faaiqm7/c5-elec391/SCRUM/SCRUM MAR-04-2025.pdf

### Scrum Results Sheet:

Team Number: L2C-C5 | Date: March-4-2025

### Scrum Master Initials: F.M

Name #1 | Adarsh Sood
| Since last scrum: - Designed new wheels

Working on today:
- Printing new wheels and designing holder for magnetic encoder Roadblocks:
- None
Name #2 | Samarr Parmaar
| Since last scrum: - Modeling of Robot

Working on today:
- Modeling of Robot and finding certain parameters
- Tuning PID coefficients
Roadblocks:
- Different methods of modeling the robot
Name #3 | Faaiq Majeed
| Since last scrum: - Worked on balancing the robot code

Working on today:
- Tuning the robot code to make it more efficient as well as creating a GUI to tune it more easily
Roadblocks:
- Robot was too jerky
