faaiqm7/c5-elec391/SCRUM/SCRUM MAR-06-2025.pdf

### Scrum Results Sheet:

Team Number: L2C-C5 | Date: March-6-2025

### Scrum Master Initials: S.P

Name #1 | Adarsh Sood
| Since last scrum: - Designed the magnetic encoder

Working on today:
- Print the magnetic encoder for the wheels
- Work on testing the magnetic encoder Roadblocks:
- None
Name #2 | Samarr Parmaar
| Since last scrum: - Modeling of Robot and helping to tune PID coefficients

Working on today:
- Modeling of Robot and finding certain parameters
- Tuning PID system
Roadblocks:
- None
Name #3 | Faaiq Majeed
| Since last scrum: - Improved the code for the self balancing robot

Working on today:
- Continue to fix inefficiencies in the self balancing robot code
- Test magnetic encoder
Roadblocks:
- Motor makes a loud sound due to the low frequency switching (turning it to 20Khz)
