faaiqm7/c5-elec391/SCRUM/SCRUM FEB-25-2025.pdf

### Scrum Results Sheet:

Team Number: L2C-C5 | Date: Feb-25-2025

### Scrum Master Initials: AS

Name #1 | Adarsh Sood
| Since last scrum: - Designed New wheels for distance tracking, ordered components like IR

Working on today:
- Rewiring to help prevent issues while testing PID due to jidders

Roadblocks:
- None
Name #2 | Samarr Parmaar
| Since last scrum: - Started looking into more research papers and 341 notes

Working on today:
- Starting to find out Gp and different parameters for making control model

Roadblocks:
- Two midterms
Name #3 | Faaiq Majeed
| Since last scrum: - Wrote a script to test PID coefficients

Working on today:
- Heuristic tunning of random PID coefficients to test code

Roadblocks:
- None
