faaiqm7/c5-elec391/SCRUM/SCRUM FEB-27-2025.pdf

### Scrum Results Sheet:

Team Number: L2C-C5 | Date: Feb-27-2025

### Scrum Master Initials: SP

Name #1 | Adarsh Sood
| Since last scrum: - Designed new IR mounts for the wheels

Working on today:
- Testing the effect of center of mass with current PID code Roadblocks:
- None
Name #2 | Samarr Parmaar
| Since last scrum: - Found Ga, starting to write matlab code

Working on today:
- Finding parameters like Gp, Ga, Hp, Hs

Roadblocks:
- Two midterms
Name #3 | Faaiq Majeed
| Since last scrum: - Adding more parameters aiding testing for PID code

Working on today:
- Helping Samarr in making basic control model

Roadblocks:
- None
