faaiqm7/c5-elec391/SCRUM/SCRUM FEB-13-2025.pdf

### Scrum Results Sheet:

Team Number: L2C-C5 | Date: Feb-13-2025

### Scrum Master Initials: FM

Name #1 | Adarsh Sood
| Since last scrum: - Re-printed a few items

Working on today:
- Work on Extra Features Proposal

Roadblocks:
- None
Name #2 | Samarr Parmaar
| Since last scrum: - Assembled the new 3D printed parts onto the robot.

Working on today:
- Work on Extra Features Proposal
- Discuss the approach we will take to implement the control system for the robot.

Roadblocks:
- None
Name #3 | Faaiq Majeed
| Since last scrum: - Worked on the GUI and testing of the robot circuitry.

Working on today:
- Work on Extra Features Proposal

Roadblocks:
- None
