faaiqm7/c5-elec391/SCRUM/SCRUM FEB-11-2025.pdf

### Scrum Results Sheet:

Team Number: L2C-C5 | Date: Feb-11-2025

### Scrum Master Initials: SP

Name #1 | Adarsh Sood
| Since last scrum: - Improved the design of the 3 rd level of the robot.

Working on today:
- Working on the RPM assignment hardware with team Roadblocks:
- Waiting for new 3D printed parts.
Name #2 | Samarr Parmaar
| Since last scrum: - Looked into research papers understanding control flows and modelling

Working on today:
- Working on the RPM assignment hardware with team
Roadblocks:
- Too many research papers
Name #3 | Faaiq Majeed
| Since last scrum: - Implemented firmware for rpm assignment with angle and IR sensor

Working on today:
- Working on the RPM with team

Roadblocks:
- Too good at coding so none (self proclaimed)
