faaiqm7/c5-elec391/SCRUM/SCRUM FEB-6-2025.pdf

### Scrum Results Sheet:

Team Number: L2C-C5 | Date: Feb-06-2025

### Scrum Master Initials: AS

Name #1 | Adarsh Sood
| Since last scrum: - Re-printed the 3rd level of the robot.

Working on today:
- Fix on the slip ring and sonar sensor.

Roadblocks:
- None
Name #2 | Samarr Parmaar
| Since last scrum: - Finished attaching all the mechanical components of the robot.

Working on today:
- Re wire the motor drive circuit to make it easier to read.

Roadblocks:
- Have to retest the motors to make sure the forward direction is forward and the backward direction is backward.
Name #3 | Faaiq Majeed
| Since last scrum: - Worked on the GUI of our robot controller python script.

Working on today:
- Figure out the RPM vs Duty Cycle characteristic curve of our DC motors.

Roadblocks:
- Figure out a method of actually measuring RPM vs Duty Cycle (perhaps IR sensors?) -
