faaiqm7/c5-elec391/SCRUM/SCRUM JAN-28-2025.pdf

### Scrum Results Sheet:

Team Number: L2C-C5 | Date: Jan/28/2025

### Scrum Master Initials: SP

Name #1 | Adarsh Sood
| Since last scrum: - Fixed Python script for angle measurement.

Working on today:
- Demonstrate angle measurement assignment with group.
- Test out logic level shifter.
Roadblocks:
- Stepper Motor cannot be powered with 3.3V, so test out logic level shifter.
Name #2 | Samarr Parmaar
| Since last scrum: - Fixed Python script for angle measurement as there were strange spikes in the graphing.

Working on today:
- Begin assembling robot kit after demonstrating angle measurement with group.

Roadblocks:
- None
Name #3 | Faaiq Majeed
| Since last scrum: - Verified the functionality of the ultrasonic sensor with Adarsh to see if it would be accurate enough.

Working on today:
- Work on Bluetooth functionality to ensure 2-way communication is smooth.
Roadblocks:
- Bluetooth is connecting between the laptop and Arduino but unable to send or receive data.
