faaiqm7/c5-elec391/ExtraFeaturesProposal/GUI.png

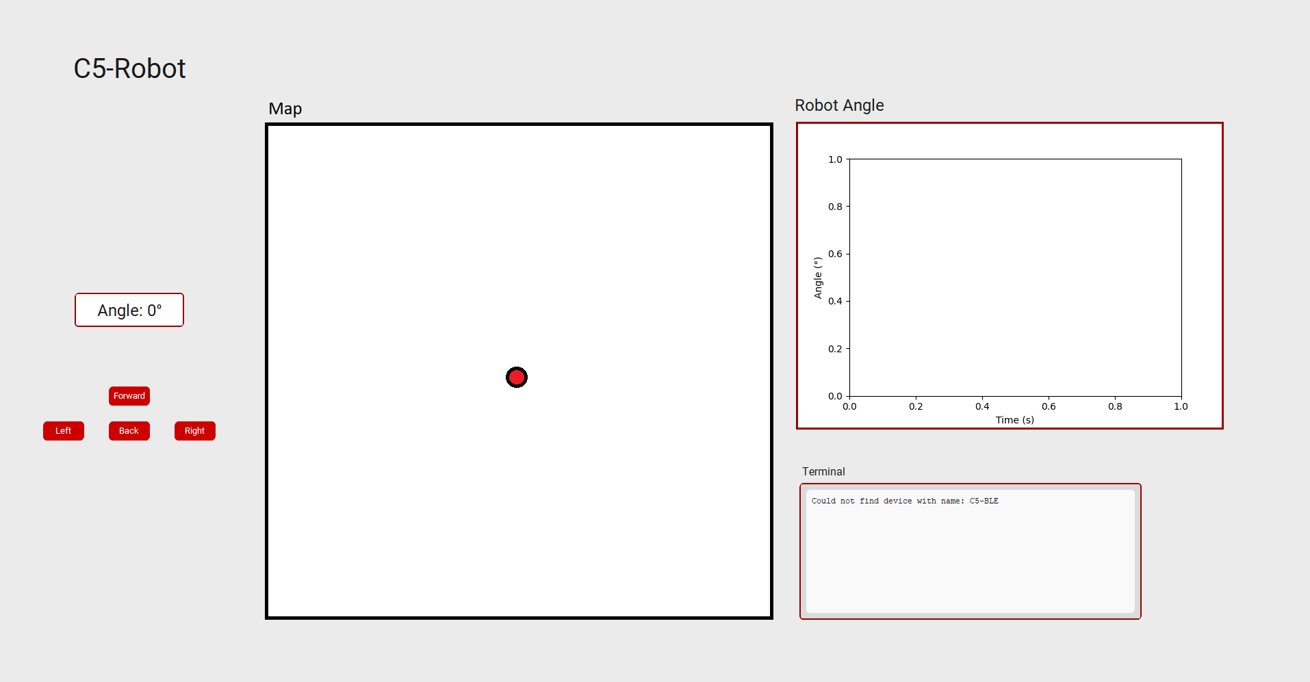
ExtraFeaturesProposal/GUI.png
