faaiqm7/c5-elec391/ExtraFeaturesProposal/DK_order_groupC5.xlsx

Group#: C5 |  | Order only from Digikey Canada
Digikey part number | Qty | Availability | Extended Price | Description
1568-SEN-24049-ND | 1 | 17 | $9.62 | ULTRASONIC DISTANCE SENSOR 3.3V
296-34699-5-ND | 1 | 7448 | $1.36 | IC TRANSLTR BIDIRECTIONAL 14SOIC
296-47192-ND | 1 | 5074 | $2.81 | IC REG LINEAR 5V 1.5A TO220-3
