faaiqm7/c5-elec391/BoM.xlsx

SI No | Item | Qty Needed | QTY w Purchase | Cost | Cost/Piece
1 | Ultrasonic Sensor (HC-SR04) | 1 | 5 | 13 | 2.6
2 | Stepper motor + Driver | 1 | 2 | 13 | 6.5
3 | IR sensor for Homing and measure | 3 | 5 | 13 | 7.8
4 | Logic Level Shifter (TXS0104E + BOB) | 1 | 1 | 5.32 | 5.32
5 | LM7805 | 1 | 1 | 2.82 | 2.82
6 | SlipRing | 1 | 1 | 15 | 15
 |  |  | Total | 62.14 | 40.04
