faaiqm7/c5-elec391/AngleMeasurement/task4/task4.py

import serial
import matplotlib.pyplot as plt
from matplotlib.animation import FuncAnimation
import time  # Import time module

"""
Name: Task 4 Python Script
Authors: Adarsh Sood, Samarr Parmaar. Faaiq Majeed (Group L2C C5)

 ################### IMPORTANT COMMENTS #####################
- For the Arduino the x-axis and y-axis are flipped/inverted (x-axis is actually y-axis vice-versa)
- From Figure 2 of the assignment PDF:
    - the y-axis on the figure is the Arduino z-axis
    - the x-axis on the figure is the Arduino y-axis
    - the z-axis on the figure is Arduino x-axis
"""

class ComplimentaryPlotter:
    def __init__(self, port="COM7", baud_rate=9600):
        self.ser = serial.Serial(port, baud_rate, timeout=1)
        self.compData, self.accData, self.gyroData, self.tData = [], [], [], []
        self.fig, self.ax = plt.subplots(figsize=(10, 6))
        self.compLine, = self.ax.plot([], [], label="Complementary", color="red")
        self.accLine, = self.ax.plot([], [], label="Accelerometer", color="green")
        self.gyroLine, = self.ax.plot([], [], label="Gyroscope", color="blue")
        self.compText = self.ax.text(0.02, 0.95, "", transform=self.ax.transAxes, fontsize=10, verticalalignment='top')
        self.accText = self.ax.text(0.02, 0.90, "", transform=self.ax.transAxes, fontsize=10, verticalalignment='top')
        self.gyroText = self.ax.text(0.02, 0.85, "", transform=self.ax.transAxes, fontsize=10, verticalalignment='top')
        self.axesSetup()
        self.start_time = time.time()  # Start time in seconds

    def axesSetup(self):
        self.ax.set_title("Complementary filter Angle with Gyro and Acceleromter readings vs Time")
        self.ax.set_xlabel("Time (s)")  # Change the label to seconds
        self.ax.set_ylabel("Angle (deg)")
        self.ax.set_ylim(-100, 100)
        self.ax.legend()

    def serialRead(self):
        try:
            while self.ser.in_waiting: # while helps clear the buffer out compared to if
                line = self.ser.readline().decode('ascii', errors='ignore').strip() 
            values = line.split(',')
            if len(values) == 3 and len(values[0]) >= 3:
                return [float(v) for v in values]
        except Exception: # ignore any errors in reading data
            pass
        return None

    def update(self, frame):
        axData = self.serialRead()
        if axData:
            # Use time to record the x-axis in seconds
            elapsed_time = time.time() - self.start_time  # Elapsed time in seconds
            self.tData.append(elapsed_time)  # Store elapsed time instead of frame count
            self.compData.append(axData[0])
            self.accData.append(axData[1])
            self.gyroData.append(axData[2])
            
            self.compLine.set_data(self.tData, self.compData)
            self.accLine.set_data(self.tData, self.accData)
            self.gyroLine.set_data(self.tData, self.gyroData)

            self.compText.set_text(f"Complementary Angle: {axData[0]:.2f} deg")
            self.accText.set_text(f"Accelerometer Angle: {axData[1]:.2f} deg")
            self.gyroText.set_text(f"Gyroscope Angle: {axData[2]:.2f} deg")

            self.ax.set_xlim(max(0, elapsed_time - 10), elapsed_time)  # Display last 10 seconds of data
            self.ax.relim()
            self.ax.autoscale_view()

        return self.compLine, self.accLine, self.gyroLine, self.compText, self.accText, self.gyroText

    def run(self):
        ani = FuncAnimation(self.fig, self.update, interval=10)
        try:
            plt.tight_layout()
            plt.show()
        except KeyboardInterrupt:
            pass
        finally:
            self.ser.close()

if __name__ == "__main__":
    plotter = ComplimentaryPlotter()
    plotter.run()
