faaiqm7/c5-elec391/(commit log)

2025-01-16 Fixed task 2 error
    [task2.ino]
2025-01-16 Fixed alot of things
    [task1.py, task2.ino, task2.py, task3.py, task4.ino, task4.py]
2025-01-17 Fixed task 4 python
    [task4.py]
2025-01-20 BoM added
    [BoM.xlsx]
2025-01-23 Added StepperHoming
2025-01-24 Fixed time axis on task 4 python
    [StepperHoming.ino, task1.ino, task1.py, task2.ino, task2.py, task3.ino, task3.py, task4.ino]
2025-01-30 updated BoM and added bluetooth files
    [BoM.xlsx]
2025-01-31 Fixed Bluetooth and started GUI
    [BLETest.ino, robotSlave.ino]
2025-02-07 MOTOR TEST CODE
2025-02-07 just some small fixes lol
    [PoC.ino]
2025-02-07 OMG GOT A BUTTON TO WORK WITH BLE :D
2025-02-10 updated code
    [DCMotorMathGraph.xlsx]
2025-02-10 gear ratio fixed
2025-02-11 updated poc with testing RPM on wheels
    [DCMotorMathGraph.xlsx]
2025-02-25 balanceRobot Code
    [DK_order_groupC5.xlsx]
2025-02-28 Updated BoM
    [BoM.xlsx]
2025-03-04 modified PID code for balanceRobot
2025-03-04 modified balancerobot PID
2025-03-05 After discussing PID stuff
2025-03-05 Before implementing BLE on PID
2025-03-06 Finished PID and BLE connection
2025-03-09 improved balanceRobot2 (more controllable) - Start tuning PID coefficients here
2025-03-11 PID library update
2025-03-12 Use tihs reference for magnetic encoder motor code
2025-03-12 thete final filtered
2025-03-12 angleFiltered has updated PID stuff
2025-03-14 implemented Kalman Filter on angleFilteredPIDBLE Code, It seems to work well in removing bias.
